maciejfic/led-letters/docs/images/app-glyphs-limit.jpg

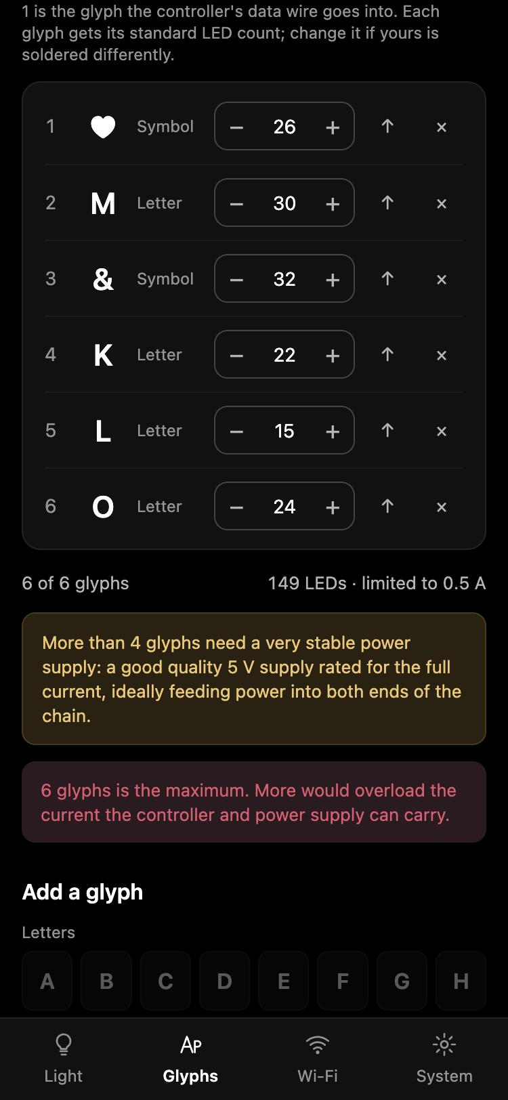
docs/images/app-glyphs-limit.jpg
