maciejfic/led-letters/(commit log)

2026-10-23 LED Letters 2.0.0: firmware, phone app, tools and docs
    ESP32-C3 firmware for modular WS2812B glyph signs (A-Z, 0-9, & @ # heart):
    runtime-configurable chain of up to 6 glyphs, setup hotspot with captive
    portal, optional home Wi-Fi with join test, web app with live sign preview,
    9 effects plus per-glyph Mixed mode, current limiting and one-button control.
    Includes the glyph catalog generator, a mock server for developing the app
    without a board, technical docs, the maker set-up guide (PDF) and a CI
    workflow that attaches ready-to-flash binaries to tagged releases.
2026-10-23 Default LED data pin to GPIO 4
    Change LED_PIN from 3 to 4 and update the wiring diagram, pin tables and
    README to match. Boards already wired to GPIO 3 need LED_PIN = 3.
2026-10-23 Group the glyph grid so the digit 0 and the letter O can't be mixed up
    The add-a-glyph grid is now split into Letters, Digits and Symbols, each
    chain row shows the glyph's kind, and digits use a slashed zero where the
    font has one. Screenshots and the user guide PDF are updated to match.
2026-10-23 Sync glyph data with the hardware design (led_map.json)
    The generator now builds every glyph from led_map.json alone: one segment
    per strip piece in wiring order (IN -> OUT), with the exact LED centres as
    its points. This fixes LED counts for 23 glyphs, the segment order and
    direction of all glyphs except K and M, and the inconsistent heart, so
    position-based effects and the app preview match the real sign. Count
    overrides and hand-made paths are gone; 40 glyphs, 915 LEDs.
    The layout places LEDs exactly at their centres at the planned count and
    still spreads them along the path when the user enters another count.
    Docs: JST SM pigtails, wire types and the 3 A connector rating in
    hardware.md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
    [layout.cpp]
2026-10-23 Glyph 4: 23 LEDs, and case hole sizes for JST plugs
    Regenerate glyph_data.h from led_map.json: the 4 now has a single LED in
    its lower stem (steps 2,7,7,6,1), 916 LEDs in total. hardware.md lists the
    case IN/OUT hole sizes (10 x 14 mm, shared 14 x 16 mm) that let a soldered
    JST SM 3-pin plug pass through.
2026-10-24 2.0.1: LED order synced with the hardware design, 24 AWG wiring docs
    Regenerate glyph_data.h from led_map.json: the LED order changed in O and Q
    (now clockwise round the bowl) and in C, E, G, I, T, V, Y, Z, 1, 2 and 7
    (every chain starts at or next to the IN hole). Counts are unchanged;
    916 LEDs in total. Position-based effects and the app preview follow.
    hardware.md: all wiring is 24 AWG (silicone jumpers behind the insert,
    bare silver-plated links on curves and bridges), fine at the default
    500 mA limit.
